mathias-aland/tincan-bms-v1/hw/bms_ver0.2.pdf

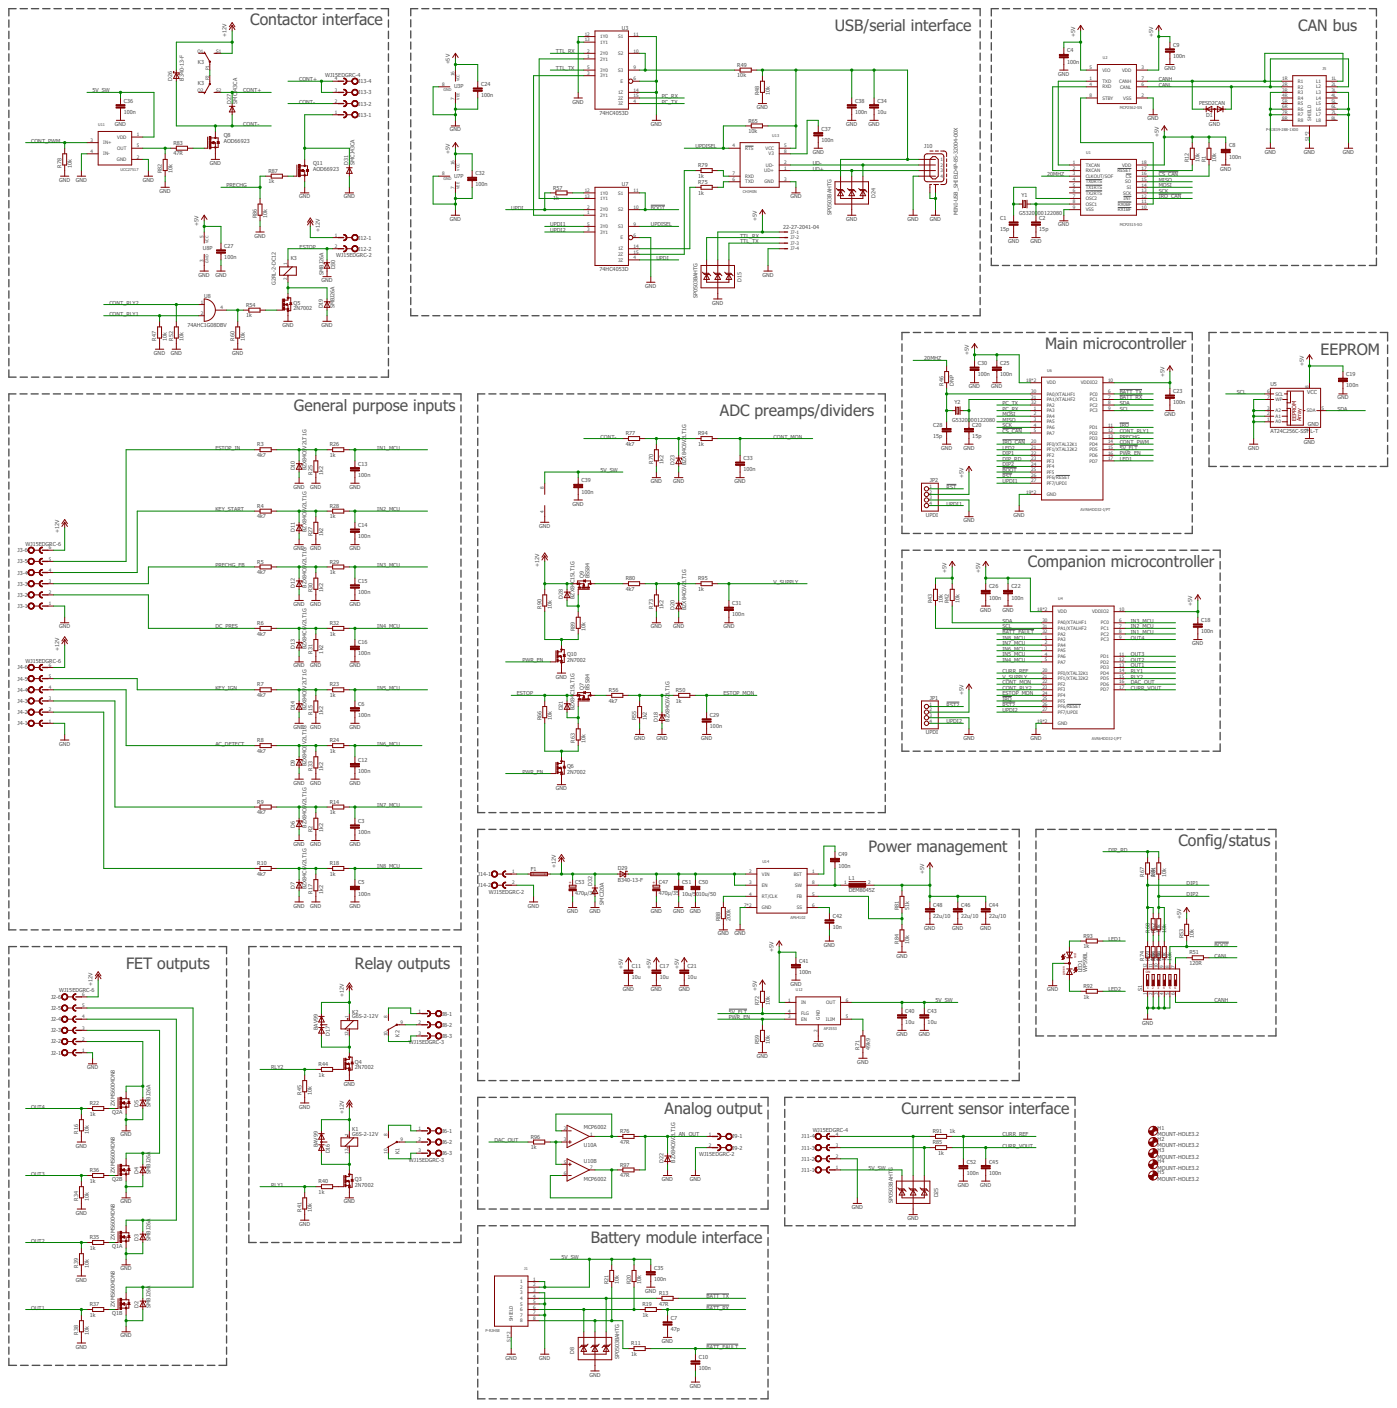
[picture p1: page 1]
