mathias-aland/tincan-bms-v1/hw/bms_ver0.2.brd

## EAGLE design hw/bms_ver0.2.brd (2024-04-16)

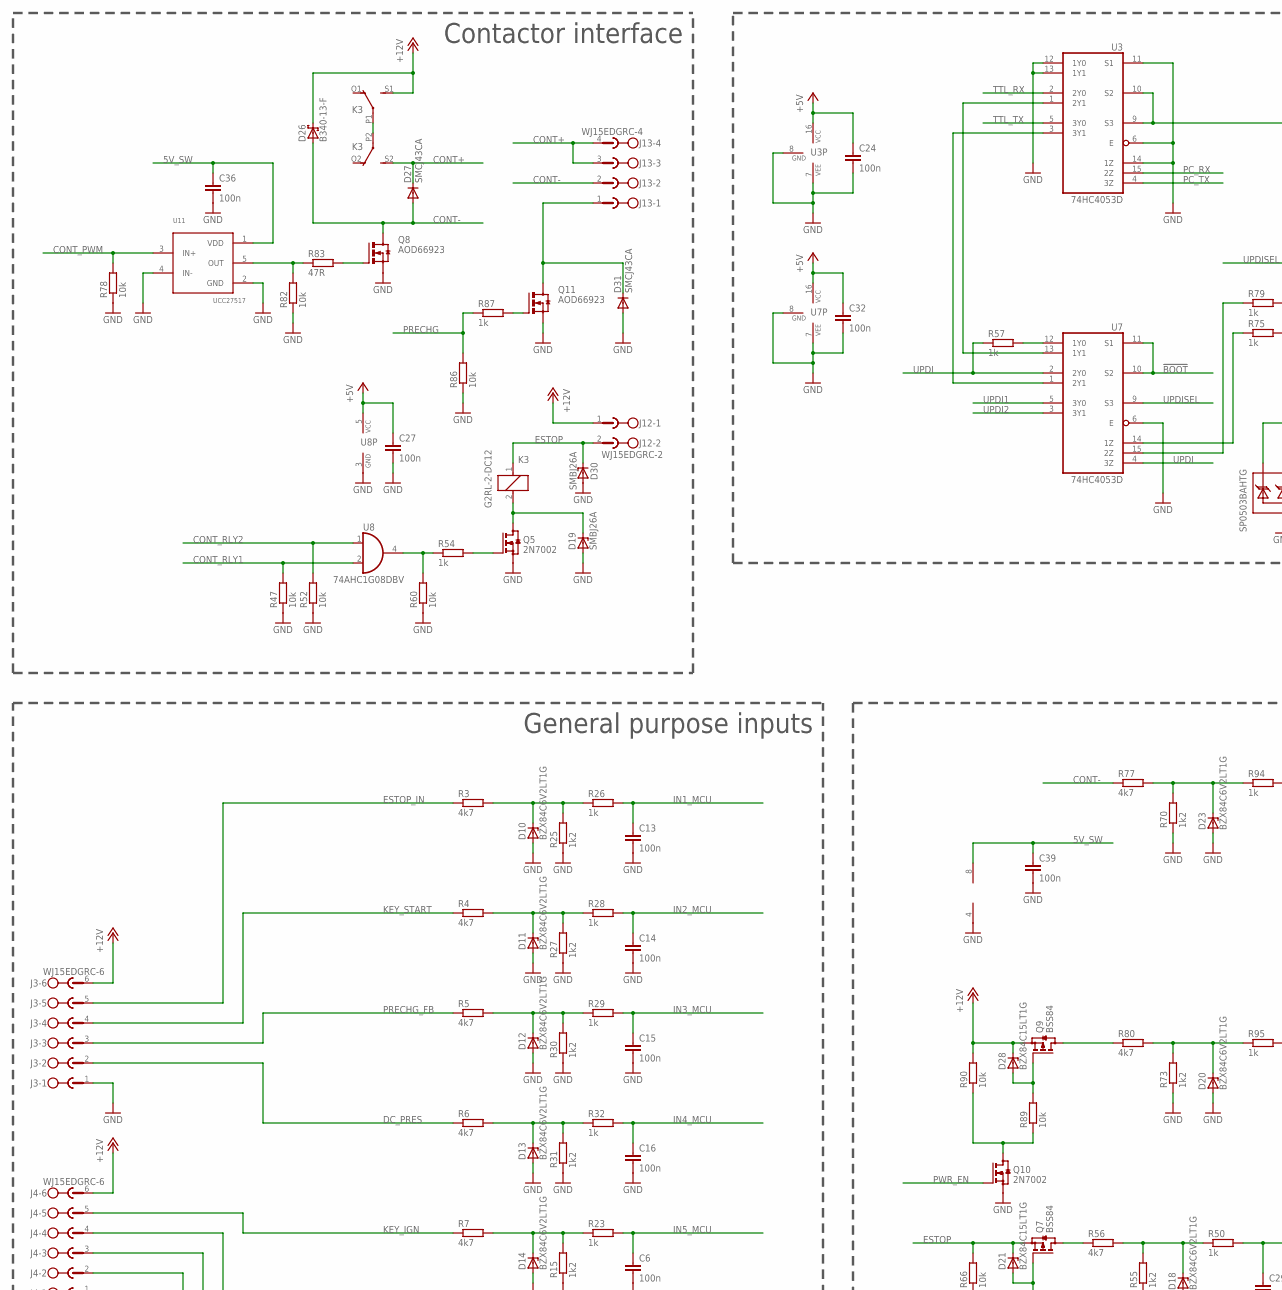
[picture p2: schematic bms_ver0.2.sch, part in row 1, column 1]

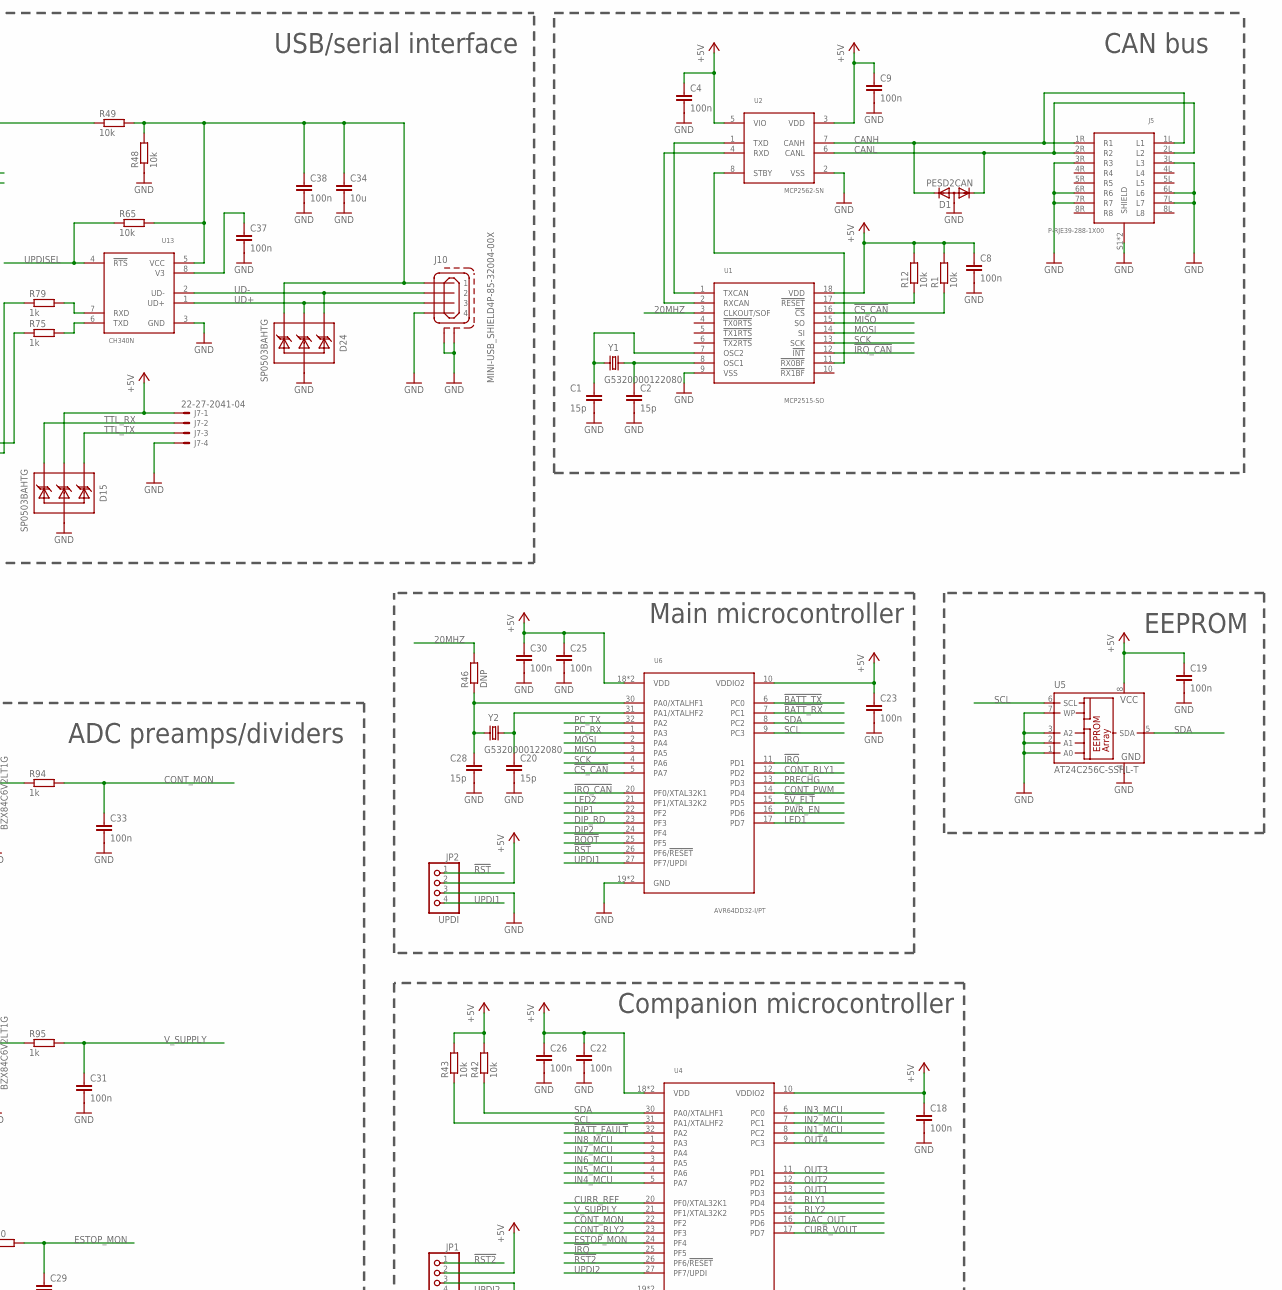
[picture p3: schematic bms_ver0.2.sch, part in row 1, column 2]

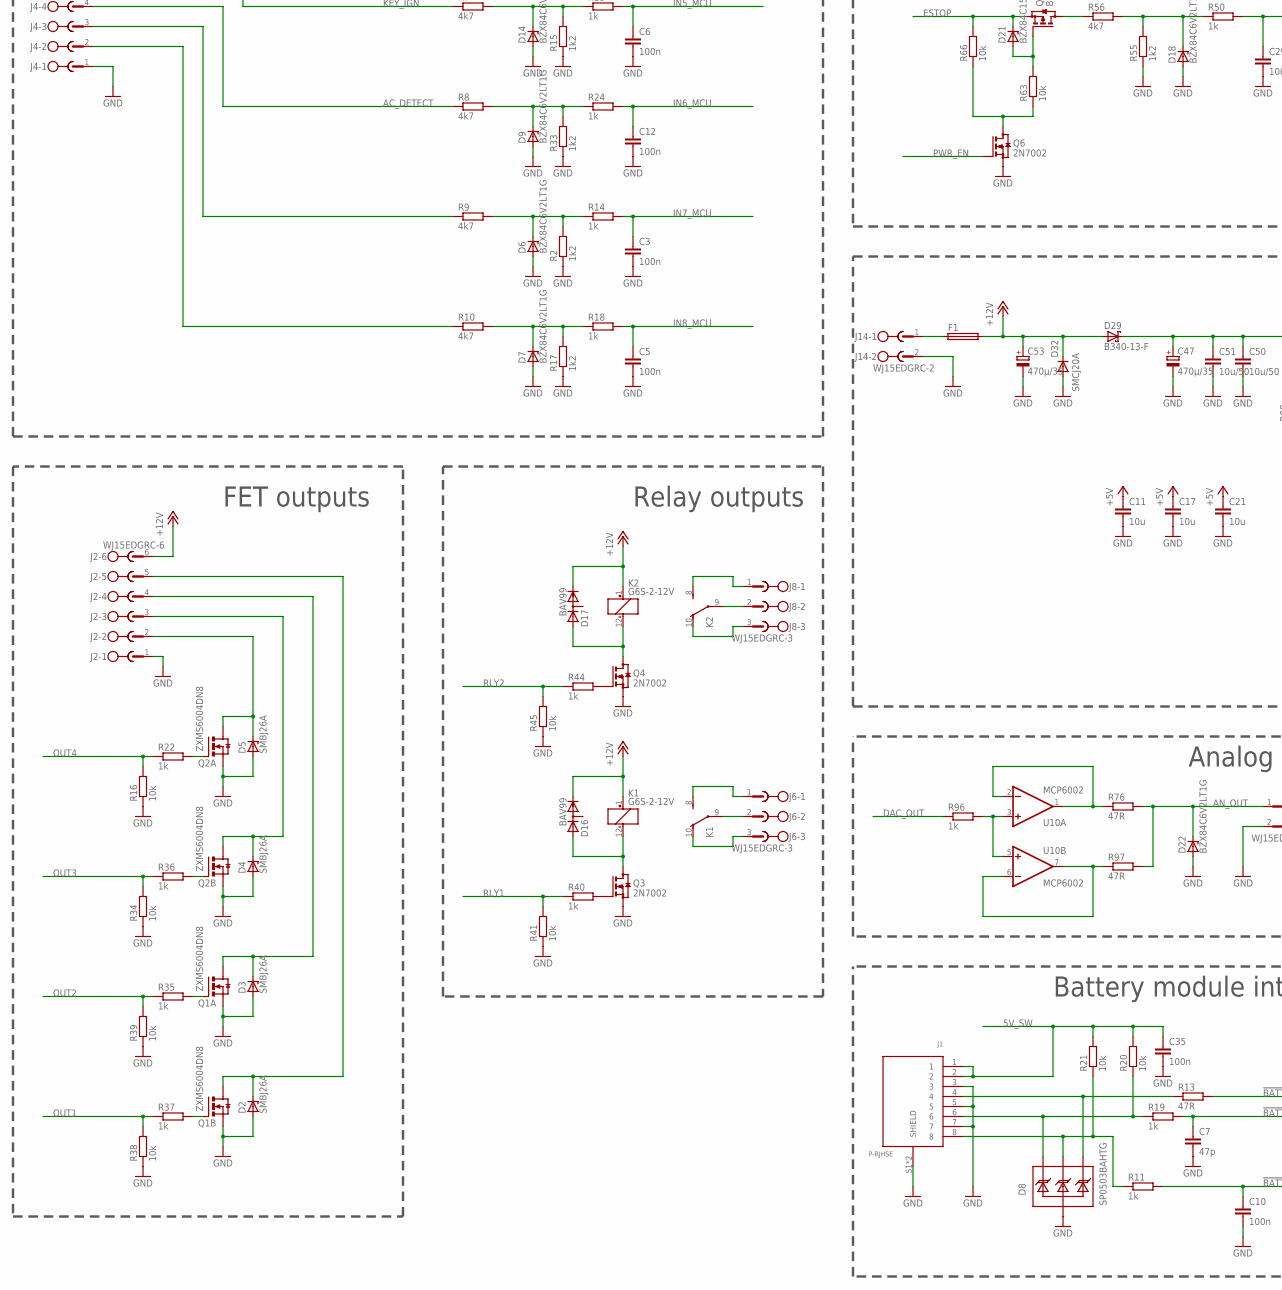
[picture p4: schematic bms_ver0.2.sch, part in row 2, column 1]

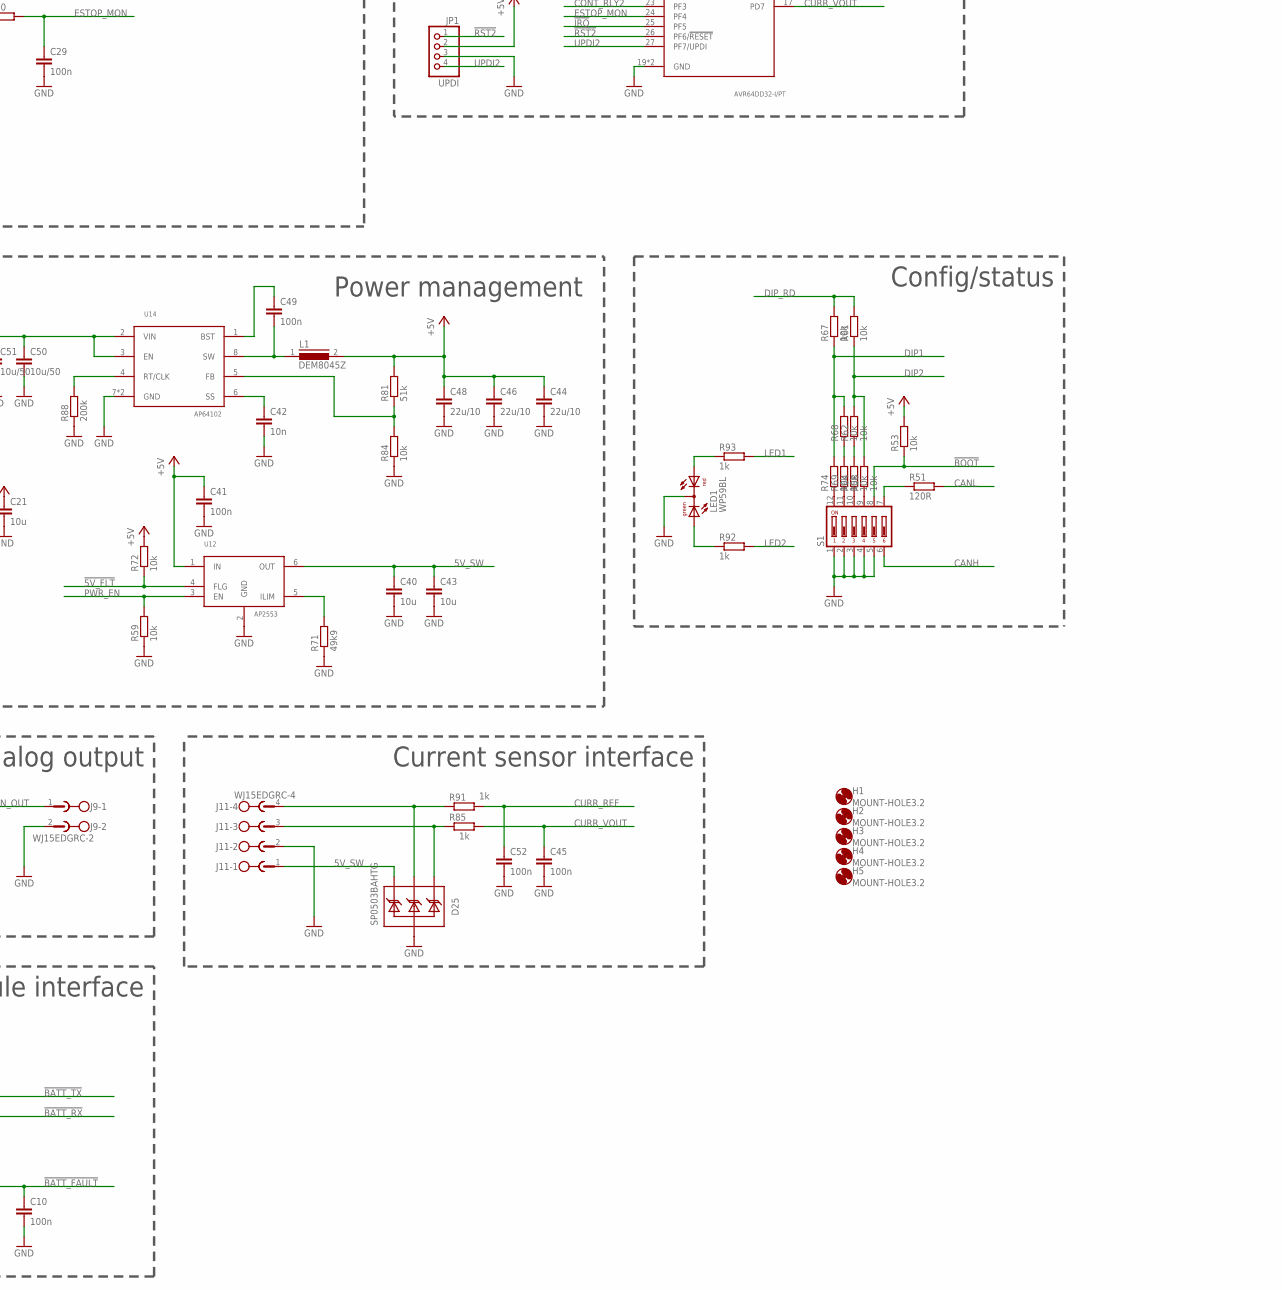
[picture p5: schematic bms_ver0.2.sch, part in row 2, column 2]

Parts:
C1, C2, C20, C28: 15p; C0805K
C3, C4, C5, C6, C8, C9, C10, C12, C13, C14, C15, C16, C18, C19, C22, C23, C24, C25, C26, C27, C29, C30, C31, C32, C33, C35, C36, C37, C38, C39, C41, C45, C49, C52: 100n; C0805K
C7: 47p; C0805K
C11, C17, C21, C34, C40, C43: 10u; C1206K
C42: 10n; C0805K
C44, C46, C48: 22u/10; C1206K
C47, C53: 470µ/35; E5-10,5
C50, C51: 10u/50; C1206K
D1: PESD2CAN; SOT23
D2, D3, D4, D5, D19, D30: SMBJ26A; SMB
D6, D7, D9, D10, D11, D12, D13, D14, D18, D20, D22, D23: BZX84C6V2LT1G; SOT23
D8, D15, D24, D25: SP0503BAHTG; SOT143
D16, D17: BAV99; SOT23
D21, D28: BZX84C15LT1G; SOT23
D26, D29: B340-13-F; SMC
D27, D31: SMCJ43CA; SMC
D32: SMCJ20A; SMC
F1: 3568
H1, H2, H3, H4, H5: MOUNT-HOLE3.2; 3,2
J1: P-RJHSE
J2, J3, J4: WJ15EDGRC-6; WJ15EDGRC-3.81-6
J5: P-RJE39-288-1X00
J6, J8: WJ15EDGRC-3; WJ15EDGRC-3.81-3
J7: 22-27-2041-04; 6410-04
J9, J12, J14: WJ15EDGRC-2; WJ15EDGRC-3.81-2
J10: MINI-USB_SHIELD4P-85-32004-00X; 85-32004-00X
J11, J13: WJ15EDGRC-4; WJ15EDGRC-3.81-4
JP1, JP2: UPDI; 1X04
K1, K2: G6S-2-12V; TXD2
K3: G2RL-2-DC12; G2R2
L1: DEM8045Z
LED1: WP59BL
Q1, Q2: ZXMS6004DN8; SO-08; MOUSER 621-ZXMS6004DN8-13
Q3, Q4, Q5, Q6, Q10: 2N7002; SOT23
Q7, Q9: BSS84; SOT23
Q8, Q11: AOD66923; D-PAK_TO252AA
R1, R12, R16, R20, R21, R34, R38, R39, R41, R42, R43, R45, R47, R48, R49, R52, R53, R58, R59, R60, R61, R62, R63, R64, R65, R66, R67, R68, R69, R72, R74, R78, R82, R84, R86, R89, R90: 10k; R0805
R2, R15, R17, R25, R27, R30, R31, R33, R55, R70, R73: 1k2; R0805
R3, R4, R5, R6, R7, R8, R9, R10, R56, R77, R80: 4k7; R1206
R11, R14, R18, R19, R22, R23, R24, R26, R28, R29, R32, R35, R36, R37, R40, R44, R50, R54, R57, R75, R79, R85, R87, R91, R92, R93, R94, R95, R96: 1k; R0805
R13, R76, R83, R97: 47R; R0805
R46: DNP; R0805
R51: 120R; R1210
R71: 49k9; R0805
R81: 51k; R0805
R88: 200k; R0805
S1: DA06; DA-06
U1: MCP2515-SO; SO-18DW
U2: MCP2562-SN; SO-08
U3, U7: 74HC4053D; SO16
U4, U6: AVR64DD32-I/PT; TQFP32-08
U5: AT24C256C-SSHL-T; SO-08
U8: 74AHC1G08DBV; SOT23-5
U10: MCP6002; SO08
U11: UCC27517; SOT23-5L
U12: AP2553; SOT23-6L
U13: CH340N; SO-08
U14: AP64102; SO08-EP
Y1, Y2: G5320000122080; CRYSTAL-TXC-7A

Connections:
5V_SW: C35.1, C36.1, C39.1, C40.1, C43.1, D25.4 (C3), J1.1, J1.2, J11.1, R20.2, R21.2, U10.8 (V+), U11.1 (VDD), U12.6 (OUT)
20MHZ: R46.2, U1.3 (CLKOUT/SOF)
!5V_FLT: R72.1, U6.15 (PD5), U12.4 (FLG)
!BATT_FAULT: C10.1, R11.2, U4.32 (PA2)
!BATT_FAULT_E: D8.3 (C2), J1.8, R11.1, R21.1
!BATT_RX: C7.1, R19.2, U6.7 (PC1)
!BATT_RX_E: D8.2 (C1), J1.6, R19.1, R20.1
!BATT_TX: R13.2, U6.6 (PC0)
!BATT_TX_E: D8.4 (C3), J1.4, R13.1
!BOOT: R53.1, S1.8, U6.25 (PF5), U7.10 (S2), U7.11 (S1)
!CS_CAN: R1.1, U1.16 (!CS), U6.5 (PA7)
!IRQ: U4.25 (PF5), U6.11 (PD1)
!IRQ_CAN: U1.12 (!INT), U6.20 (PF0/XTAL32K1)
!RST: JP2.1, U6.26 (PF6/!RESET)
!RST2: JP1.1, U4.26 (PF6/!RESET)
+5V: C4.1, C8.1, C9.1, C11.1, C17.1, C18.1, C19.1, C21.1, C22.1, C23.1, C24.1, C25.1, C26.1, C27.1, C30.1, C32.1, C41.1, C44.1, C46.1, C48.1, D15.3 (C2), J7.1, JP1.2, JP2.2, L1.2, R1.2, R12.2, R42.2, R43.2, R53.2, R72.2, R81.2, U1.18 (VDD), U2.3 (VDD), U2.5 (VIO), U3.16 (VCC), U4.10 (VDDIO2), U4.18 (VDD), U4.28 (VDD), U5.8 (VCC), U6.10 (VDDIO2), U6.18 (VDD), U6.28 (VDD), U7.16 (VCC), U8.5 (VCC), U12.1 (IN)
+12V: C53.+, D16.2 (C), D17.2 (C), D26.C, D28.3 (C), D29.A, D32.C, F1.2A (2), F1.2B (2), J2.6, J3.6, J4.6, J12.1, K1.1 (+), K2.1 (+), K3.S1 (S), Q9.2 (S), R90.2
AC_DETECT: J4.4, R8.1
AC_DETECT_F: D9.3 (C), R8.2, R24.1, R33.2
AN_OUT: D22.3 (C), J9.1, R76.2, R97.2
CANH: D1.2 (K2), J5.1L (L1), J5.1R (R1), S1.6, U2.7 (CANH)
CANL: D1.1 (K1), J5.2L (L2), J5.2R (R2), R51.2, U2.6 (CANL)
CONT+: D27.C, J13.3, J13.4, K3.S2 (S)
CONT-: D26.A, D27.A, J13.2, Q8.4 (D), R77.1
CONT_MON: C33.1, R94.2, U4.22 (PF2)
CONT_PWM: R78.2, U6.14 (PD4), U11.3 (IN+)
CONT_RLY1: R47.2, U6.12 (PD2), U8.2 (I1)
CONT_RLY2: R52.2, U4.23 (PF3), U8.1 (I0)
CURR_REF: C52.1, R91.2, U4.20 (PF0/XTAL32K1)
CURR_VOUT: C45.1, R85.2, U4.17 (PD7)
DAC_OUT: R96.1, U4.16 (PD6)
DC_PRES: J3.2, R6.1
DC_PRES_F: D13.3 (C), R6.2, R31.2, R32.1
DIP1: R67.1, R68.2, R74.2, U6.22 (PF2)
DIP2: R58.2, R61.1, R62.2, U6.24 (PF4)
DIP_RD: R61.2, R67.2, U6.23 (PF3)
ESTOP: D21.3 (C), D30.C, J12.2, K3.1, Q7.2 (S), R66.2
ESTOP_IN: J3.5, R3.1
ESTOP_MON: C29.1, R50.2, U4.24 (PF4)
GND: C1.2, C2.2, C3.2, C4.2, C5.2, C6.2, C7.2, C8.2, C9.2, C10.2, C11.2, C12.2, C13.2, C14.2, C15.2, C16.2, C17.2, C18.2, C19.2, C20.2, C21.2, C22.2, C23.2, C24.2, C25.2, C26.2, C27.2, C28.2, C29.2, C30.2, C31.2, C32.2, C33.2, C34.2, C35.2, C36.2, C37.2, C38.2, C39.2, C40.2, C41.2, C42.2, C43.2, C44.2, C45.2, C46.2, C47.-, C48.2, C50.2, C51.2, C52.2, C53.-, D1.3 (A), D2.A, D3.A, D4.A, D5.A, D6.1 (A), D7.1 (A), D8.1 (A), D9.1 (A), D10.1 (A), D11.1 (A), D12.1 (A), D13.1 (A), D14.1 (A), D15.1 (A), D18.1 (A), D19.A, D20.1 (A), D22.1 (A), D23.1 (A), D24.1 (A), D25.1 (A), D30.A, D31.A, D32.A, J1.3, J1.5, J1.7, J1.S1 (SHIELD), J1.S2 (SHIELD), J2.1, J3.1, J4.1, J5.3L (L3), J5.3R (R3), J5.6L (L6), J5.6R (R6), J5.7L (L7), J5.7R (R7), J5.S1 (SHIELD), J5.S2 (SHIELD), J7.4, J9.2, J10.4, J10.M1 (S1), J10.M2 (S2), J11.2, J14.2, JP1.3, JP2.3, LED1.2 (C), Q1.1 (S), Q1.3 (S), Q2.1 (S), Q2.3 (S), Q3.2 (S), Q4.2 (S), Q5.2 (S), Q6.2 (S), Q8.3 (S), Q10.2 (S), Q11.3 (S), R2.1, R15.1, R16.1, R17.1, R25.1, R27.1, R30.1, R31.1, R33.1, R34.1, R38.1, R39.1, R41.1, R45.1, R47.1, R48.1, R52.1, R55.1, R59.1, R60.1, R70.1, R71.1, R73.1, R78.1, R82.1, R84.1, R86.1, R88.1, S1.1, S1.2, S1.3, S1.4, S1.5, U1.9 (VSS), U2.2 (VSS), U3.6 (E), U3.7 (VEE), U3.8 (GND), U3.11 (S1), U3.12 (1Y0), U3.13 (1Y1), U3.14 (1Z), U4.19 (GND), U4.29 (GND), U5.1 (A0), U5.2 (A1), U5.3 (A2), U5.4 (GND), U5.7 (WP), U6.19 (GND), U6.29 (GND), U7.6 (E), U7.7 (VEE), U7.8 (GND), U8.3 (GND), U10.4 (V-), U11.2 (GND), U11.4 (IN-), U12.2 (GND), U13.3 (GND), U14.7 (GND), U14.PAD (GND)
GPI1_F: D6.3 (C), R2.2, R9.2, R14.1
GPI2_F: D7.3 (C), R10.2, R17.2, R18.1
IN1_MCU: C13.1, R26.2, U4.8 (PC2)
IN2_MCU: C14.1, R28.2, U4.7 (PC1)
IN3_MCU: C15.1, R29.2, U4.6 (PC0)
IN4_MCU: C16.1, R32.2, U4.5 (PA7)
IN5_MCU: C6.1, R23.2, U4.4 (PA6)
IN6_MCU: C12.1, R24.2, U4.3 (PA5)
IN7_MCU: C3.1, R14.2, U4.2 (PA4)
IN8_MCU: C5.1, R18.2, U4.1 (PA3)
KEY_IGN: J4.5, R7.1
KEY_IGN_F: D14.3 (C), R7.2, R15.2, R23.1
KEY_START: J3.4, R4.1
LED1: R93.2, U6.17 (PD7)
LED2: R92.2, U6.21 (PF1/XTAL32K2)
MISO: U1.15 (SO), U6.3 (PA5)
MOSI: U1.14 (SI), U6.2 (PA4)
unnamed: R69.1, S1.11
unnamed: C1.1, U1.7 (OSC2), Y1.P$2 (2)
unnamed: C2.1, U1.8 (OSC1), Y1.P$1 (1)
unnamed: U1.1 (TXCAN), U2.1 (TXD)
unnamed: U1.2 (RXCAN), U2.4 (RXD)
unnamed: R74.1, S1.12
unnamed: R51.1, S1.7
unnamed: C37.1, U13.8 (V3)
unnamed: C28.1, R46.1, U6.30 (PA0/XTALHF1), Y2.P$2 (2)
unnamed: C20.1, U6.31 (PA1/XTALHF2), Y2.P$1 (1)
unnamed: R75.2, U13.6 (TXD)
unnamed: R75.1, U7.14 (1Z)
unnamed: R71.2, U12.5 (ILIM)
unnamed: R62.1, R64.2
unnamed: F1.1A (1), F1.1B (1), J14.1
unnamed: R82.2, R83.1, U11.5 (OUT)
unnamed: Q8.1 (G), R83.2
unnamed: R96.2, U10.3 (+IN), U10.5 (+IN)
unnamed: J6.2, K1.9
unnamed: J6.1, K1.8 (S)
unnamed: LED1.3 (AG), R92.1
unnamed: R68.1, R69.2
unnamed: LED1.1 (AR), R93.1
unnamed: R58.1, S1.9
unnamed: R64.1, S1.10
unnamed: R76.1, U10.1 (OUT), U10.2 (-IN)
unnamed: R97.1, U10.6 (-IN), U10.7 (OUT)
unnamed: C34.1, C38.1, D24.4 (C3), J10.1, R48.2, R49.2, R65.2, U13.5 (VCC)
unnamed: D11.3 (C), R4.2, R27.2, R28.1
unnamed: D31.C, J13.1, Q11.4 (D)
unnamed: D19.C, K3.2, Q5.3 (D)
unnamed: R54.1, R60.2, U8.4 (O)
unnamed: Q4.1 (G), R44.2
unnamed: Q5.1 (G), R54.2
unnamed: D17.1 (A), K2.12 (-), Q4.3 (D)
unnamed: Q3.1 (G), R40.2
unnamed: D16.1 (A), K1.12 (-), Q3.3 (D)
unnamed: J8.2, K2.9
unnamed: J8.1, K2.8 (S)
unnamed: J8.3, K2.10 (O)
unnamed: R57.2, U7.12 (1Y0)
unnamed: K3.P1, K3.P2
unnamed: Q1.2 (G), R37.2
unnamed: D25.2 (C1), J11.3, R85.1
unnamed: D25.3 (C2), J11.4, R91.1
unnamed: J4.3, R9.1
unnamed: J4.2, R10.1
unnamed: Q9.3 (D), R80.1
unnamed: J6.3, K1.10 (O)
unnamed: R79.2, U13.7 (RXD)
unnamed: Q11.1 (G), R87.2
unnamed: D12.3 (C), R5.2, R29.1, R30.2
unnamed: D18.3 (C), R50.1, R55.2, R56.2
unnamed: D28.1 (A), Q9.1 (G), R89.2
unnamed: U3.1 (2Y1), U7.13 (1Y1)
unnamed: U3.3 (3Y1), U7.1 (2Y1)
unnamed: D10.3 (C), R3.2, R25.2, R26.1
unnamed: C49.1, U14.1 (BST)
unnamed: R12.1, U1.17 (!RESET)
unnamed: D20.3 (C), R73.2, R80.2, R95.1
unnamed: C49.2, L1.1, U14.8 (SW)
unnamed: D23.3 (C), R70.2, R77.2, R94.1
unnamed: Q10.3 (D), R89.1, R90.1
unnamed: D21.1 (A), Q7.1 (G), R63.2
unnamed: R79.1, U7.15 (2Z)
unnamed: R49.1, U3.9 (S3), U3.10 (S2)
unnamed: Q6.3 (D), R63.1, R66.1
unnamed: Q7.3 (D), R56.1
unnamed: R81.1, R84.2, U14.5 (FB)
unnamed: C42.1, U14.6 (SS)
unnamed: U1.11 (!RX0BF), U2.8 (STBY)
unnamed: R88.2, U14.4 (RT/CLK)
unnamed: C47.+, C50.1, C51.1, D29.C, U14.2 (VIN), U14.3 (EN)
unnamed: D5.C, J2.2, Q2.5 (D), Q2.6 (D)
unnamed: D2.C, J2.5, Q1.7 (D), Q1.8 (D)
unnamed: D3.C, J2.4, Q1.5 (D), Q1.6 (D)
unnamed: D4.C, J2.3, Q2.7 (D), Q2.8 (D)
unnamed: Q2.4 (G), R22.2
unnamed: Q2.2 (G), R36.2
unnamed: Q1.4 (G), R35.2
OUT1: R37.1, R38.2, U4.13 (PD3)
OUT2: R35.1, R39.2, U4.12 (PD2)
OUT3: R34.2, R36.1, U4.11 (PD1)
OUT4: R16.2, R22.1, U4.9 (PC3)
PC_RX: U3.15 (2Z), U6.1 (PA3)
PC_TX: U3.4 (3Z), U6.32 (PA2)
PRECHG: R86.2, R87.1, U6.13 (PD3)
PRECHG_FB: J3.3, R5.1
PWR_EN: Q6.1 (G), Q10.1 (G), R59.2, U6.16 (PD6), U12.3 (EN)
RLY1: R40.1, R41.2, U4.14 (PD4)
RLY2: R44.1, R45.2, U4.15 (PD5)
SCK: U1.13 (SCK), U6.4 (PA6)
SCL: R43.1, U4.31 (PA1/XTALHF2), U5.6 (SCL), U6.9 (PC3)
SDA: R42.1, U4.30 (PA0/XTALHF1), U5.5 (SDA), U6.8 (PC2)
TTL_RX: D15.4 (C3), J7.2, U3.2 (2Y0)
TTL_TX: D15.2 (C1), J7.3, U3.5 (3Y0)
UD+: D24.3 (C2), J10.3, U13.1 (UD+)
UD-: D24.2 (C1), J10.2, U13.2 (UD-)
UPDI: R57.1, U7.2 (2Y0), U7.4 (3Z)
UPDI1: JP2.4, U6.27 (PF7/UPDI), U7.5 (3Y0)
UPDI2: JP1.4, U4.27 (PF7/UPDI), U7.3 (3Y1)
UPDISEL: R65.1, U7.9 (S3), U13.4 (!RTS)
V_SUPPLY: C31.1, R95.2, U4.21 (PF1/XTAL32K2)

Notes on the sheet:
FET outputs
Relay outputs
Power management
USB/serial interface
CAN bus
EEPROM
Main microcontroller
Config/status
Battery module interface
General purpose inputs
Companion microcontroller
Contactor interface
Analog output
ADC preamps/dividers
Current sensor interface

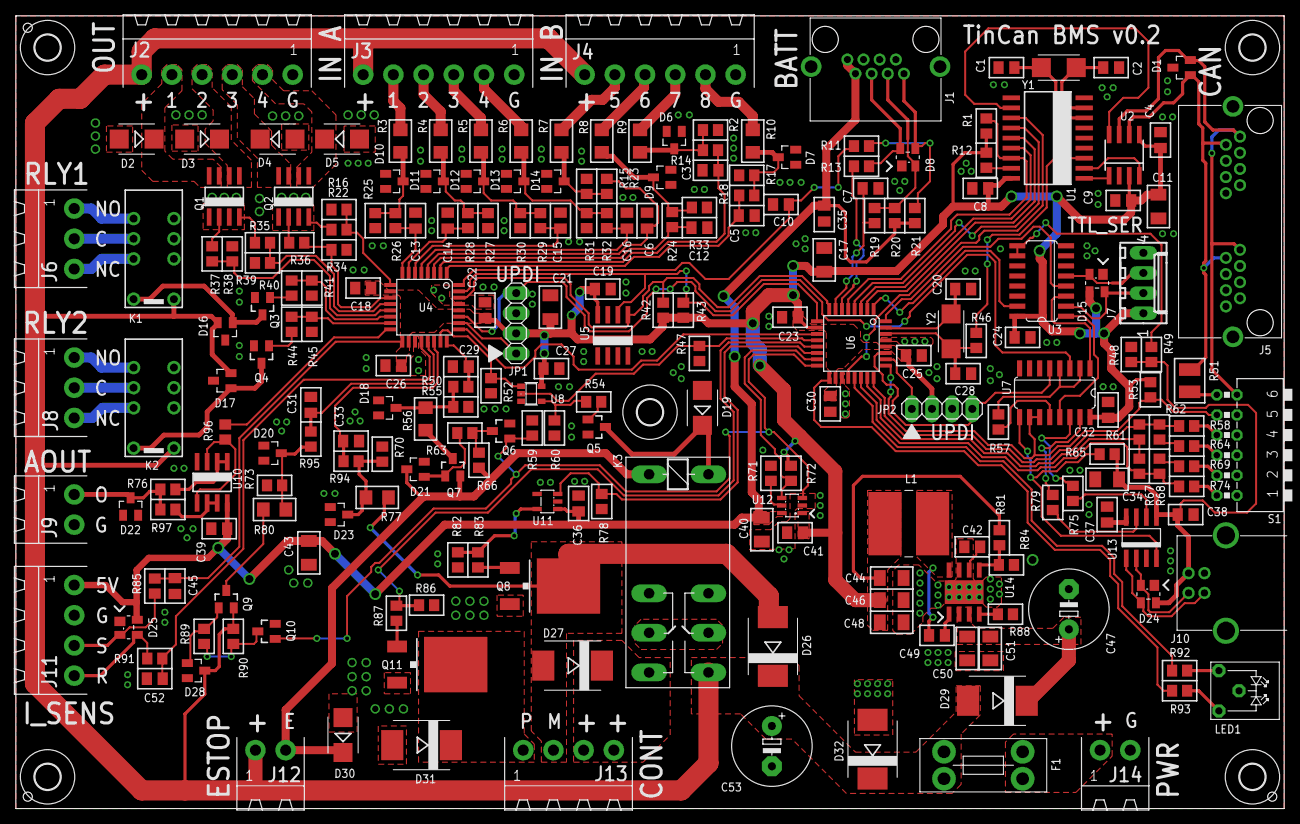
[picture p6: board bms_ver0.2.brd from above]

Board: 2 copper layers, 160.0 x 100.0 mm, 236 parts (0 on the bottom side), 160 nets.
