mathias-aland/tincan-bms-v1/(commit log)

2024-04-16 Add PCB schematic/layout
    [bms_ver0.2.brd, bms_ver0.2.sch]
2024-04-17 Misc fixes in FW/SW
    - Add more debug stats
    - Improve comm fault flag handling for battery modules
    - Change default fault/alert mask bits
    - Improve pump/heater logic
    - Double buffering and increased number of decimals in config utility
    [batt.c, eeprom.c, globals.c, globals.h, i2c.c, logic_checks.c, logic_checks.h, main.c]
2024-04-21 Fix cell balancing logic
    [batt.c, main.c]
2024-04-25 Rewrite balancing logic
    Also add ability to enter BOOT mode from software, HW mod needed: wire jumper from U1 (MCP2515) pin 10 to S1 (DIP switch) position 5 (signal side, not ground side)
2024-12-16 Various bug fixes and improvements
    [batt.c, bmsmodule.h, main.c]
